ceteras/Cobra-XP/img/QR.png

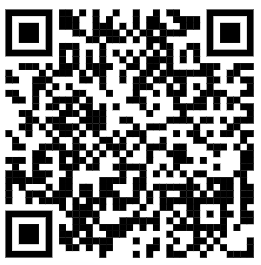
img/QR.png
