ceteras/Cobra-XP/extensions/template/img/template.pdf

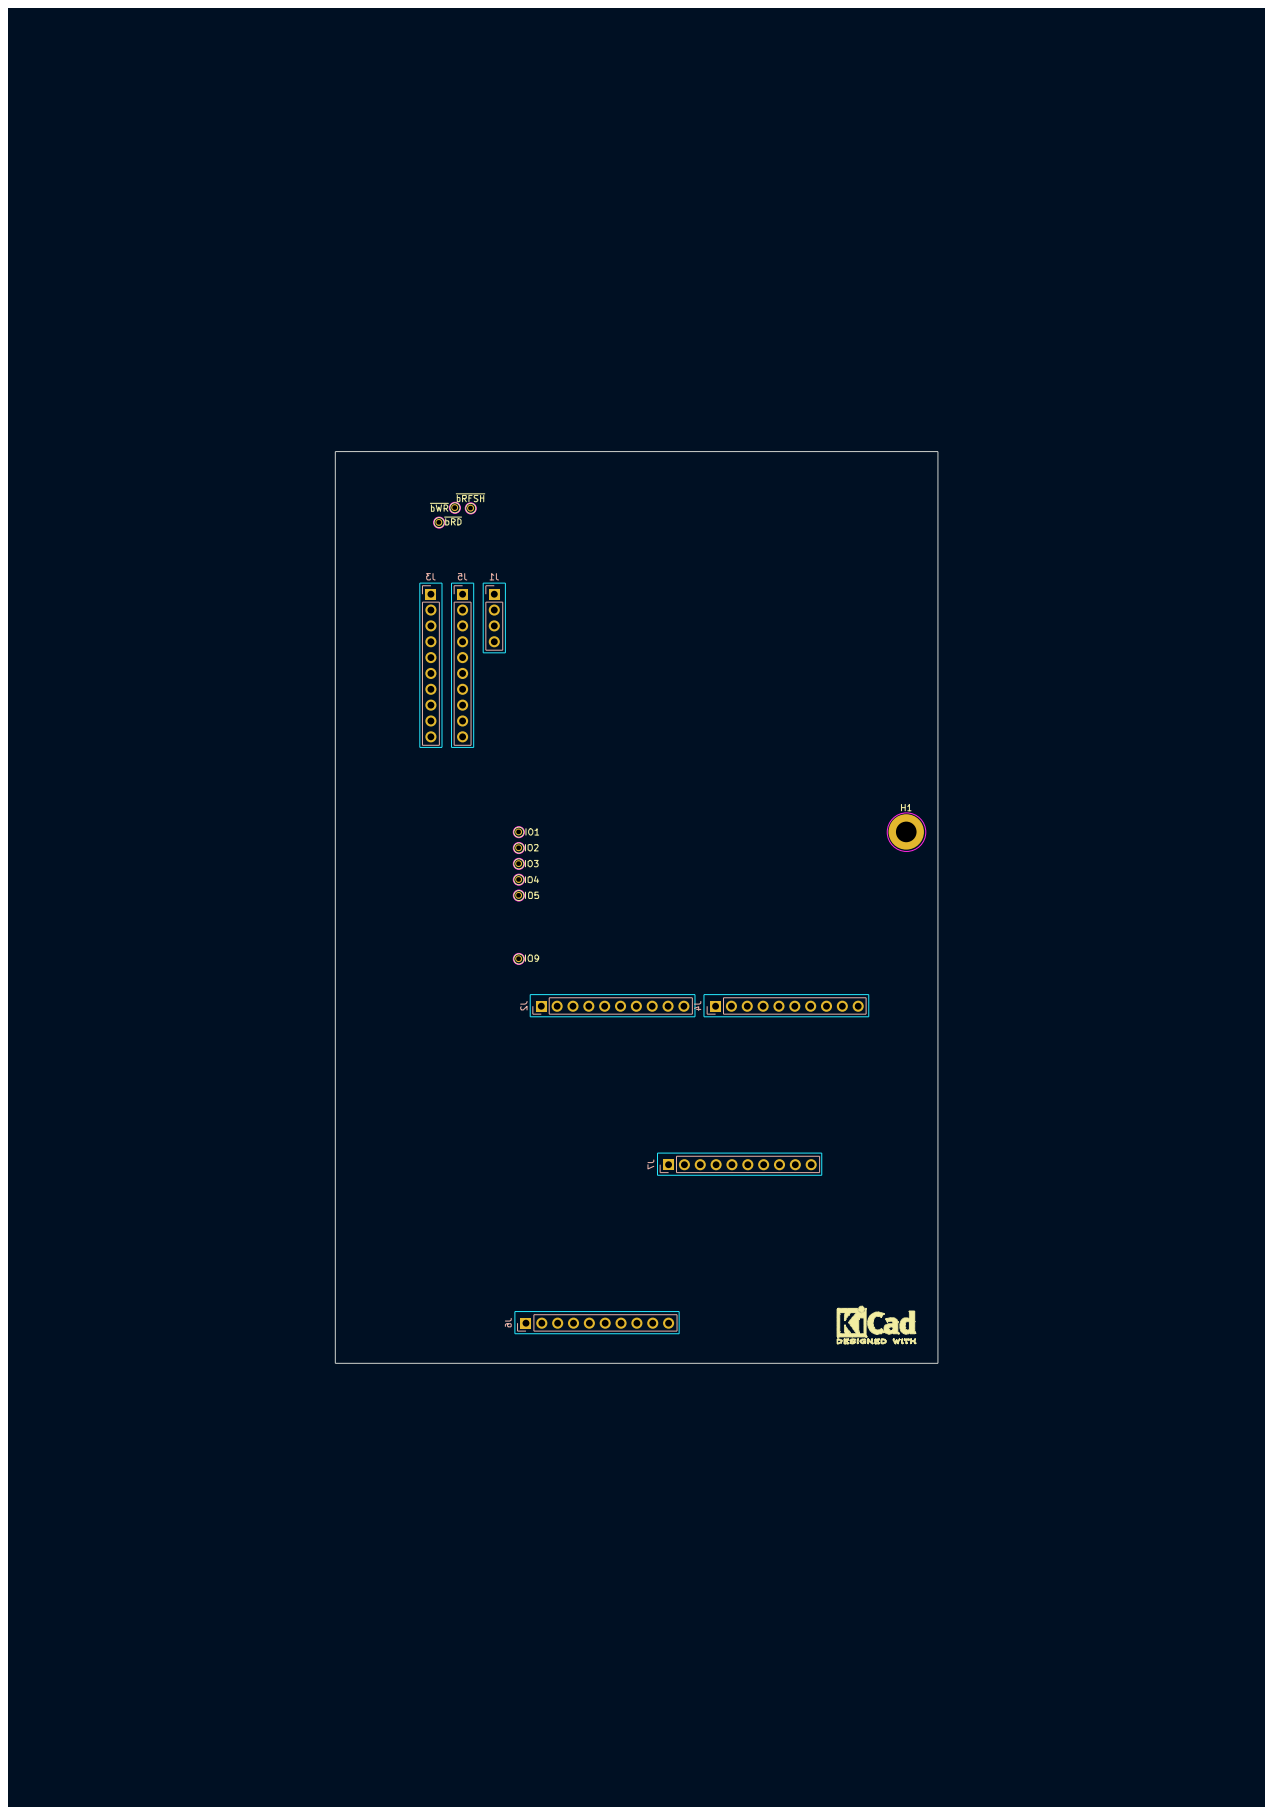
[picture p5: page 1]
