ceteras/Cobra-XP/kicad/Extras.kicad_sch

## KiCad design kicad/Extras.kicad_sch (2024-11-02)

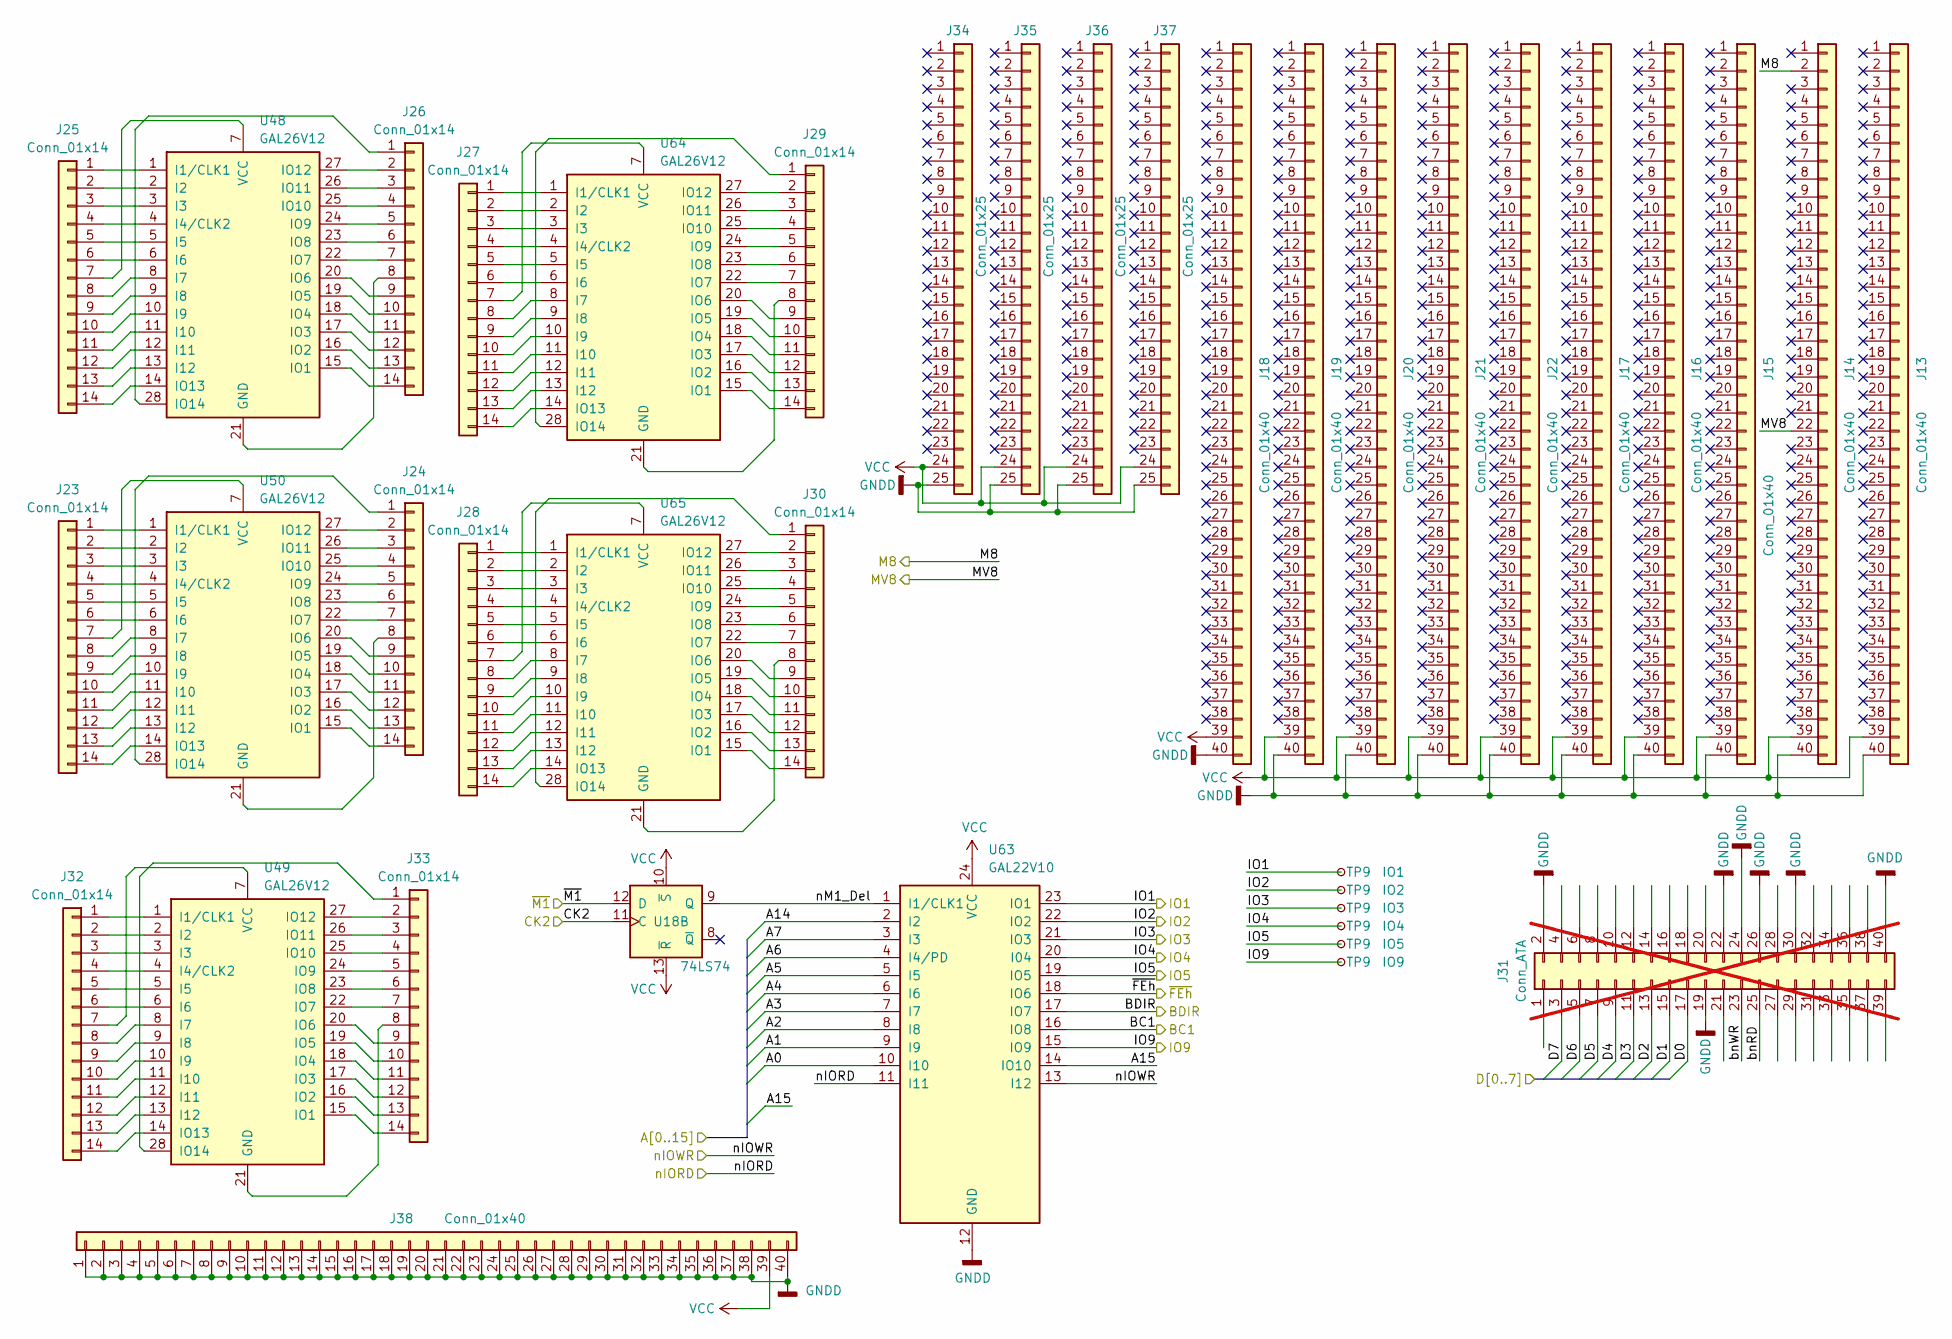
[picture p6: schematic Extras.kicad_sch]

Parts:
J13, J14, J15, J16, J17, J18, J19, J20, J21, J22, J38: Conn_01x40; PinHeader_1x40_P2.54mm_Vertical
J23, J24, J25, J26, J27, J28, J29, J30, J32, J33: Conn_01x14; PinHeader_1x14_P2.54mm_Vertical
J31: Conn_ATA; PinHeader_2x20_P2.54mm_Vertical; not fitted
J34, J35, J36, J37: Conn_01x25; PinHeader_1x25_P2.54mm_Vertical
TP9: IO2; TestPoint_Hole_D1mm_Drill0.6mm
U18: 74LS74; DIP-14_W7.62mm
U48, U49, U50, U64, U65: GAL26V12; DIP-28_W7.62mm
U63: GAL22V10; DIP-24_W7.62mm

Connections:
A0: U63.10 (I10)
A1: U63.9 (I9)
A2: U63.8 (I8)
A3: U63.7 (I7)
A4: U63.6 (I6)
A5: U63.5 (I5)
A6: U63.4 (I4/PD)
A7: U63.3 (I3)
A14: U63.2 (I2)
A15: U63.14 (IO10)
BC1: U63.16 (IO8)
BDIR: U63.17 (IO7)
CK2: U18.11 (C)
D0: J31.17
D1: J31.15
D2: J31.13
D3: J31.11
D4: J31.9
D5: J31.7
D6: J31.5
D7: J31.3
GNDD: J13.40, J14.40, J15.40, J16.40, J17.40, J18.40, J19.40, J20.40, J21.40, J22.40, J31.2, J31.19, J31.22, J31.24, J31.26, J31.30, J31.40, J34.25, J35.25, J36.25, J37.25, J38.1, J38.2, J38.3, J38.4, J38.5, J38.6, J38.7, J38.8, J38.9, J38.10, J38.11, J38.12, J38.13, J38.14, J38.15, J38.16, J38.17, J38.18, J38.19, J38.20, J38.21, J38.22, J38.23, J38.24, J38.25, J38.26, J38.27, J38.28, J38.29, J38.30, J38.31, J38.32, J38.33, J38.34, J38.35, J38.36, J38.37, J38.38, J38.40, U63.12 (GND)
IO1: TP9.1, U63.23 (IO1)
IO2: TP9.1, U63.22 (IO2)
IO3: TP9.1, U63.21 (IO3)
IO4: TP9.1, U63.20 (I04)
IO5: TP9.1, U63.19 (IO5)
IO9: TP9.1, U63.15 (IO9)
M8: J14.2
MV8: J14.22
unnamed: J23.1, U50.1 (I1/CLK1)
unnamed: J23.2, U50.2 (I2)
unnamed: J23.3, U50.3 (I3)
unnamed: J23.4, U50.4 (I4/CLK2)
unnamed: J23.5, U50.5 (I5)
unnamed: J23.6, U50.6 (I6)
unnamed: J23.7, U50.7 (VCC)
unnamed: J23.8, U50.8 (I7)
unnamed: J23.9, U50.9 (I8)
unnamed: J23.10, U50.10 (I9)
unnamed: J23.11, U50.11 (I10)
unnamed: J23.12, U50.12 (I11)
unnamed: J23.13, U50.13 (I12)
unnamed: J23.14, U50.14 (IO13)
unnamed: J24.1, U50.28 (IO14)
unnamed: J24.2, U50.27 (IO12)
unnamed: J24.3, U50.26 (IO11)
unnamed: J24.4, U50.25 (IO10)
unnamed: J24.5, U50.24 (IO9)
unnamed: J24.6, U50.23 (IO8)
unnamed: J24.7, U50.22 (IO7)
unnamed: J24.8, U50.21 (GND)
unnamed: J24.9, U50.20 (IO6)
unnamed: J24.10, U50.19 (IO5)
unnamed: J24.11, U50.18 (IO4)
unnamed: J24.12, U50.17 (IO3)
unnamed: J24.13, U50.16 (IO2)
unnamed: J24.14, U50.15 (IO1)
unnamed: J25.1, U48.1 (I1/CLK1)
unnamed: J25.2, U48.2 (I2)
unnamed: J25.3, U48.3 (I3)
unnamed: J25.4, U48.4 (I4/CLK2)
unnamed: J25.5, U48.5 (I5)
unnamed: J25.6, U48.6 (I6)
unnamed: J25.7, U48.7 (VCC)
unnamed: J25.8, U48.8 (I7)
unnamed: J25.9, U48.9 (I8)
unnamed: J25.10, U48.10 (I9)
unnamed: J25.11, U48.11 (I10)
unnamed: J25.12, U48.12 (I11)
unnamed: J25.13, U48.13 (I12)
unnamed: J25.14, U48.14 (IO13)
unnamed: J26.1, U48.28 (IO14)
unnamed: J26.2, U48.27 (IO12)
unnamed: J26.3, U48.26 (IO11)
unnamed: J26.4, U48.25 (IO10)
unnamed: J26.5, U48.24 (IO9)
unnamed: J26.6, U48.23 (IO8)
unnamed: J26.7, U48.22 (IO7)
unnamed: J26.8, U48.21 (GND)
unnamed: J26.9, U48.20 (IO6)
unnamed: J26.10, U48.19 (IO5)
unnamed: J26.11, U48.18 (IO4)
unnamed: J26.12, U48.17 (IO3)
unnamed: J26.13, U48.16 (IO2)
unnamed: J26.14, U48.15 (IO1)
unnamed: J27.1, U64.1 (I1/CLK1)
unnamed: J27.2, U64.2 (I2)
unnamed: J27.3, U64.3 (I3)
unnamed: J27.4, U64.4 (I4/CLK2)
unnamed: J27.5, U64.5 (I5)
unnamed: J27.6, U64.6 (I6)
unnamed: J27.7, U64.7 (VCC)
unnamed: J27.8, U64.8 (I7)
unnamed: J27.9, U64.9 (I8)
unnamed: J27.10, U64.10 (I9)
unnamed: J27.11, U64.11 (I10)
unnamed: J27.12, U64.12 (I11)
unnamed: J27.13, U64.13 (I12)
unnamed: J27.14, U64.14 (IO13)
unnamed: J28.1, U65.1 (I1/CLK1)
unnamed: J28.2, U65.2 (I2)
unnamed: J28.3, U65.3 (I3)
unnamed: J28.4, U65.4 (I4/CLK2)
unnamed: J28.5, U65.5 (I5)
unnamed: J28.6, U65.6 (I6)
unnamed: J28.7, U65.7 (VCC)
unnamed: J28.8, U65.8 (I7)
unnamed: J28.9, U65.9 (I8)
unnamed: J28.10, U65.10 (I9)
unnamed: J28.11, U65.11 (I10)
unnamed: J28.12, U65.12 (I11)
unnamed: J28.13, U65.13 (I12)
unnamed: J28.14, U65.14 (IO13)
unnamed: J29.1, U64.28 (IO14)
unnamed: J29.2, U64.27 (IO12)
unnamed: J29.3, U64.26 (IO11)
unnamed: J29.4, U64.25 (IO10)
unnamed: J29.5, U64.24 (IO9)
unnamed: J29.6, U64.23 (IO8)
unnamed: J29.7, U64.22 (IO7)
unnamed: J29.8, U64.21 (GND)
unnamed: J29.9, U64.20 (IO6)
unnamed: J29.10, U64.19 (IO5)
unnamed: J29.11, U64.18 (IO4)
unnamed: J29.12, U64.17 (IO3)
unnamed: J29.13, U64.16 (IO2)
unnamed: J29.14, U64.15 (IO1)
unnamed: J30.1, U65.28 (IO14)
unnamed: J30.2, U65.27 (IO12)
unnamed: J30.3, U65.26 (IO11)
unnamed: J30.4, U65.25 (IO10)
unnamed: J30.5, U65.24 (IO9)
unnamed: J30.6, U65.23 (IO8)
unnamed: J30.7, U65.22 (IO7)
unnamed: J30.8, U65.21 (GND)
unnamed: J30.9, U65.20 (IO6)
unnamed: J30.10, U65.19 (IO5)
unnamed: J30.11, U65.18 (IO4)
unnamed: J30.12, U65.17 (IO3)
unnamed: J30.13, U65.16 (IO2)
unnamed: J30.14, U65.15 (IO1)
unnamed: J32.1, U49.1 (I1/CLK1)
unnamed: J32.2, U49.2 (I2)
unnamed: J32.3, U49.3 (I3)
unnamed: J32.4, U49.4 (I4/CLK2)
unnamed: J32.5, U49.5 (I5)
unnamed: J32.6, U49.6 (I6)
unnamed: J32.7, U49.7 (VCC)
unnamed: J32.8, U49.8 (I7)
unnamed: J32.9, U49.9 (I8)
unnamed: J32.10, U49.10 (I9)
unnamed: J32.11, U49.11 (I10)
unnamed: J32.12, U49.12 (I11)
unnamed: J32.13, U49.13 (I12)
unnamed: J32.14, U49.14 (IO13)
unnamed: J33.1, U49.28 (IO14)
unnamed: J33.2, U49.27 (IO12)
unnamed: J33.3, U49.26 (IO11)
unnamed: J33.4, U49.25 (IO10)
unnamed: J33.5, U49.24 (IO9)
unnamed: J33.6, U49.23 (IO8)
unnamed: J33.7, U49.22 (IO7)
unnamed: J33.8, U49.21 (GND)
unnamed: J33.9, U49.20 (IO6)
unnamed: J33.10, U49.19 (IO5)
unnamed: J33.11, U49.18 (IO4)
unnamed: J33.12, U49.17 (IO3)
unnamed: J33.13, U49.16 (IO2)
unnamed: J33.14, U49.15 (IO1)
VCC: J13.39, J14.39, J15.39, J16.39, J17.39, J18.39, J19.39, J20.39, J21.39, J22.39, J34.24, J35.24, J36.24, J37.24, J38.39, U18.10 (~S), U18.13 (~R), U63.24 (VCC)
bnRD: J31.25
bnWR: J31.23
nIORD: U63.11 (I11)
nIOWR: U63.13 (I12)
nM1_Del: U18.9 (Q), U63.1 (I1/CLK1)
~FEh: U63.18 (IO6)
~M1: U18.12 (D)
