ceteras/Cobra-XP/kicad/RAM_48.kicad_sch

## KiCad design kicad/RAM_48.kicad_sch (2024-11-02)

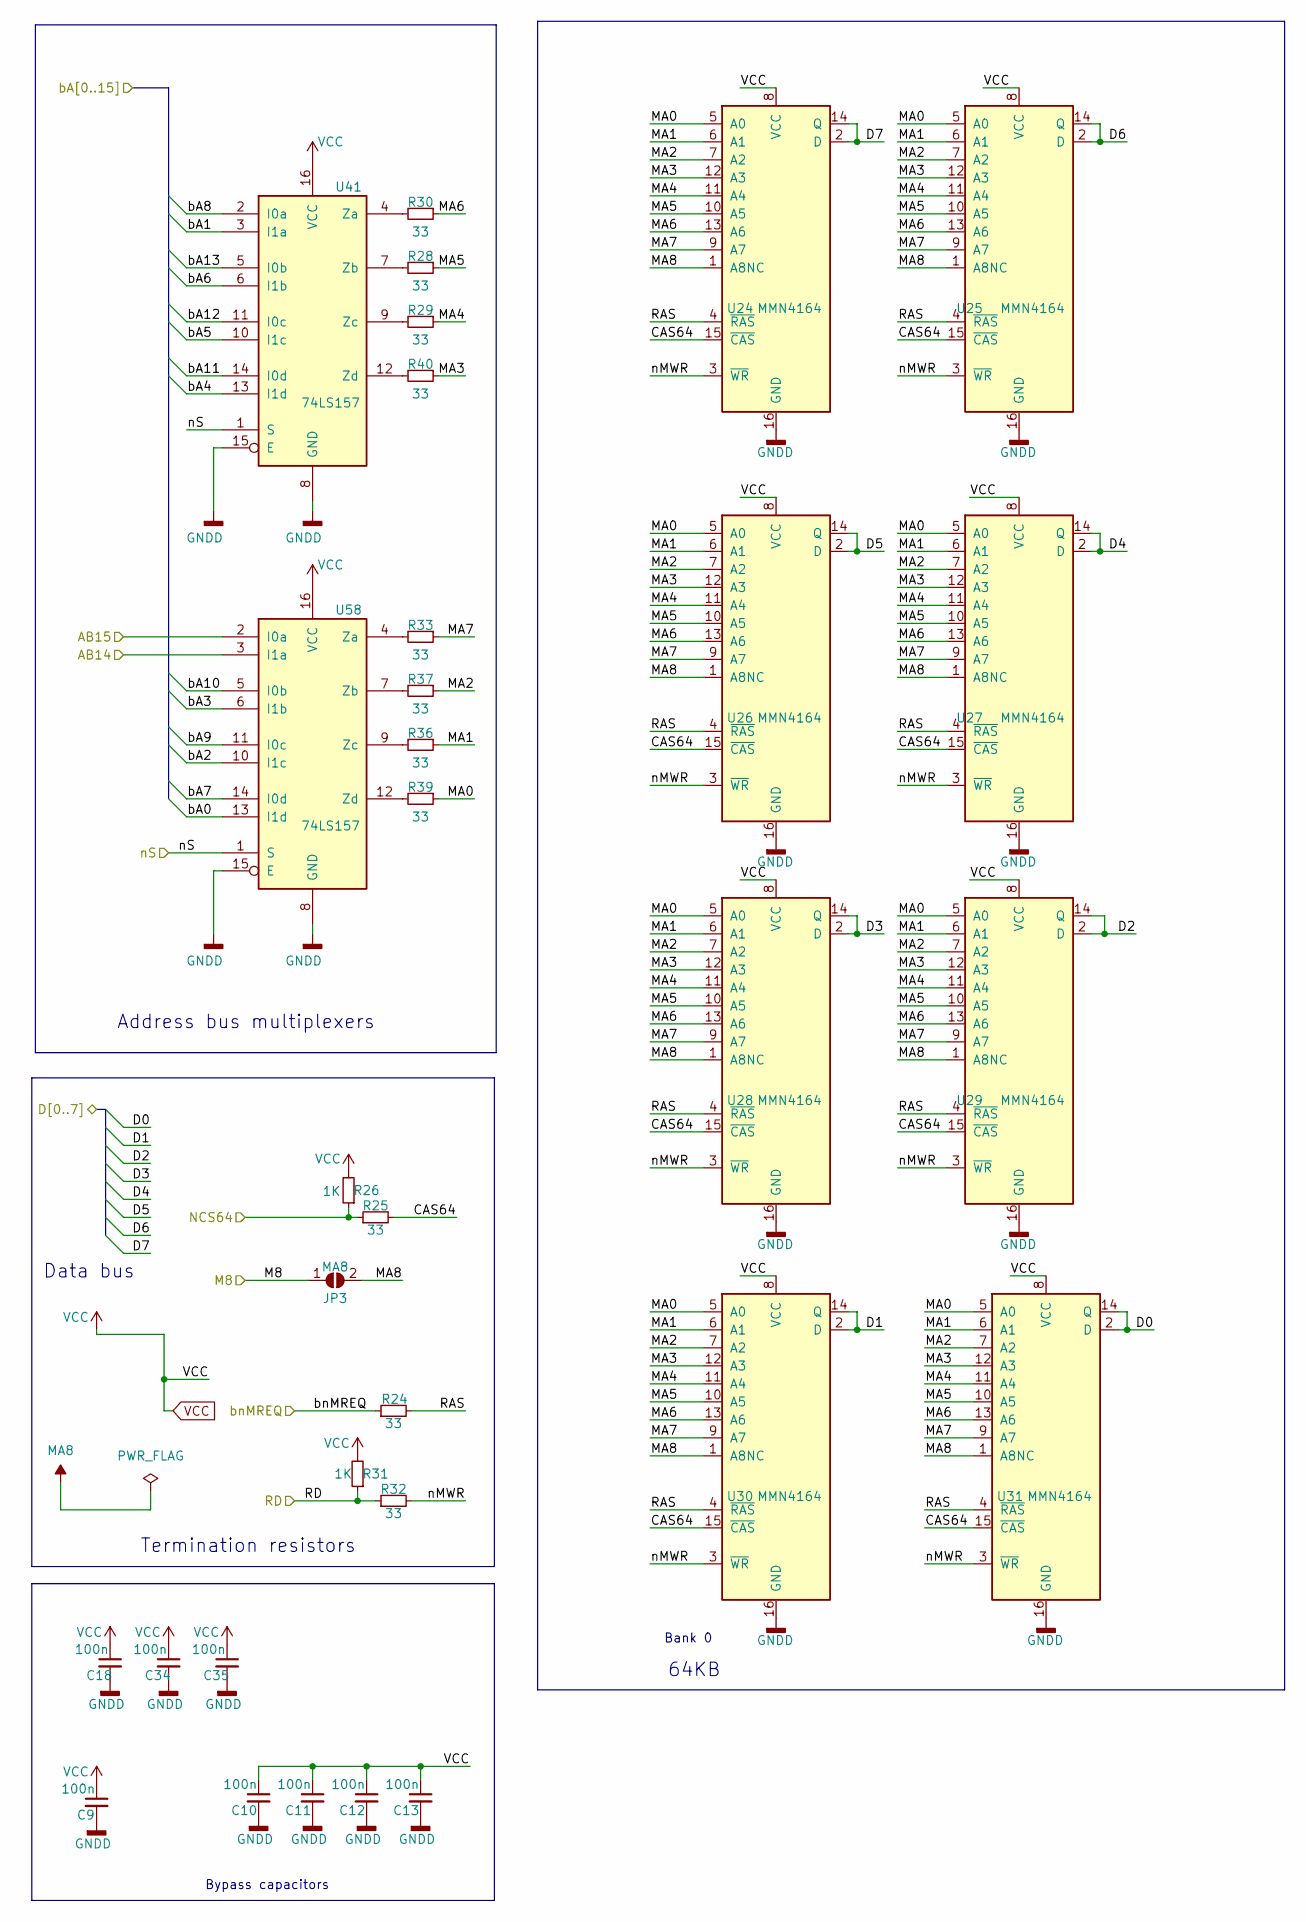
[picture p10: schematic RAM_48.kicad_sch]

Parts:
C9, C10, C11, C12, C13, C18, C34, C35: 100n; C_THT_762_254
JP3: MA8; SolderJumper-2_P1.3mm_Open_TrianglePad1.0x1.5mm
R24, R25, R28, R29, R30, R32, R33, R36, R37, R39, R40: 33; R_Axial_DIN0204_L3.6mm_D1.6mm_P5.08mm_Horizontal
R26, R31: 1K; R_Axial_DIN0204_L3.6mm_D1.6mm_P5.08mm_Horizontal
U24, U25, U26, U27, U28, U29, U30, U31: MMN4164; DIP-16_W7.62mm
U41, U58: 74LS157; DIP-16_W7.62mm

Connections:
AB14: U58.3 (I1a)
AB15: U58.2 (I0a)
CAS64: R25.2, U24.15 (~CAS), U25.15 (~CAS), U26.15 (~CAS), U27.15 (~CAS), U28.15 (~CAS), U29.15 (~CAS), U30.15 (~CAS), U31.15 (~CAS)
D0: U31.2 (D), U31.14 (Q)
D1: U30.2 (D), U30.14 (Q)
D2: U29.2 (D), U29.14 (Q)
D3: U28.2 (D), U28.14 (Q)
D4: U27.2 (D), U27.14 (Q)
D5: U26.2 (D), U26.14 (Q)
D6: U25.2 (D), U25.14 (Q)
D7: U24.2 (D), U24.14 (Q)
GNDD: C9.2, C10.2, C11.2, C12.2, C13.2, C18.2, C34.2, C35.2, U24.16 (GND), U25.16 (GND), U26.16 (GND), U27.16 (GND), U28.16 (GND), U29.16 (GND), U30.16 (GND), U31.16 (GND), U41.8 (GND), U41.15 (E), U58.8 (GND), U58.15 (E)
M8: JP3.1 (A)
MA0: R39.1, U24.5 (A0), U25.5 (A0), U26.5 (A0), U27.5 (A0), U28.5 (A0), U29.5 (A0), U30.5 (A0), U31.5 (A0)
MA1: R36.1, U24.6 (A1), U25.6 (A1), U26.6 (A1), U27.6 (A1), U28.6 (A1), U29.6 (A1), U30.6 (A1), U31.6 (A1)
MA2: R37.1, U24.7 (A2), U25.7 (A2), U26.7 (A2), U27.7 (A2), U28.7 (A2), U29.7 (A2), U30.7 (A2), U31.7 (A2)
MA3: R40.1, U24.12 (A3), U25.12 (A3), U26.12 (A3), U27.12 (A3), U28.12 (A3), U29.12 (A3), U30.12 (A3), U31.12 (A3)
MA4: R29.1, U24.11 (A4), U25.11 (A4), U26.11 (A4), U27.11 (A4), U28.11 (A4), U29.11 (A4), U30.11 (A4), U31.11 (A4)
MA5: R28.1, U24.10 (A5), U25.10 (A5), U26.10 (A5), U27.10 (A5), U28.10 (A5), U29.10 (A5), U30.10 (A5), U31.10 (A5)
MA6: R30.1, U24.13 (A6), U25.13 (A6), U26.13 (A6), U27.13 (A6), U28.13 (A6), U29.13 (A6), U30.13 (A6), U31.13 (A6)
MA7: R33.1, U24.9 (A7), U25.9 (A7), U26.9 (A7), U27.9 (A7), U28.9 (A7), U29.9 (A7), U30.9 (A7), U31.9 (A7)
MA8: JP3.2 (B), U24.1 (A8NC), U25.1 (A8NC), U26.1 (A8NC), U27.1 (A8NC), U28.1 (A8NC), U29.1 (A8NC), U30.1 (A8NC), U31.1 (A8NC)
NCS64: R25.1, R26.1
unnamed: R28.2, U41.7 (Zb)
unnamed: R29.2, U41.9 (Zc)
unnamed: R30.2, U41.4 (Za)
unnamed: R33.2, U58.4 (Za)
unnamed: R36.2, U58.9 (Zc)
unnamed: R37.2, U58.7 (Zb)
unnamed: R39.2, U58.12 (Zd)
unnamed: R40.2, U41.12 (Zd)
RAS: R24.2, U24.4 (~RAS), U25.4 (~RAS), U26.4 (~RAS), U27.4 (~RAS), U28.4 (~RAS), U29.4 (~RAS), U30.4 (~RAS), U31.4 (~RAS)
RD: R31.1, R32.1
VCC: C9.1, C10.1, C11.1, C12.1, C13.1, C18.1, C34.1, C35.1, R26.2, R31.2, U24.8 (VCC), U25.8 (VCC), U26.8 (VCC), U27.8 (VCC), U28.8 (VCC), U29.8 (VCC), U30.8 (VCC), U31.8 (VCC), U41.16 (VCC), U58.16 (VCC)
bA0: U58.13 (I1d)
bA1: U41.3 (I1a)
bA2: U58.10 (I1c)
bA3: U58.6 (I1b)
bA4: U41.13 (I1d)
bA5: U41.10 (I1c)
bA6: U41.6 (I1b)
bA7: U58.14 (I0d)
bA8: U41.2 (I0a)
bA9: U58.11 (I0c)
bA10: U58.5 (I0b)
bA11: U41.14 (I0d)
bA12: U41.11 (I0c)
bA13: U41.5 (I0b)
bnMREQ: R24.1
nMWR: R32.2, U24.3 (~WR), U25.3 (~WR), U26.3 (~WR), U27.3 (~WR), U28.3 (~WR), U29.3 (~WR), U30.3 (~WR), U31.3 (~WR)
nS: U41.1 (S), U58.1 (S)

Notes on the sheet:
Bypass capacitors
Data bus
Address bus multiplexers
64KB
Bank 0
Termination resistors
