ceteras/Cobra-XP/kicad/ROM.kicad_sch

## KiCad design kicad/ROM.kicad_sch (2024-11-02)

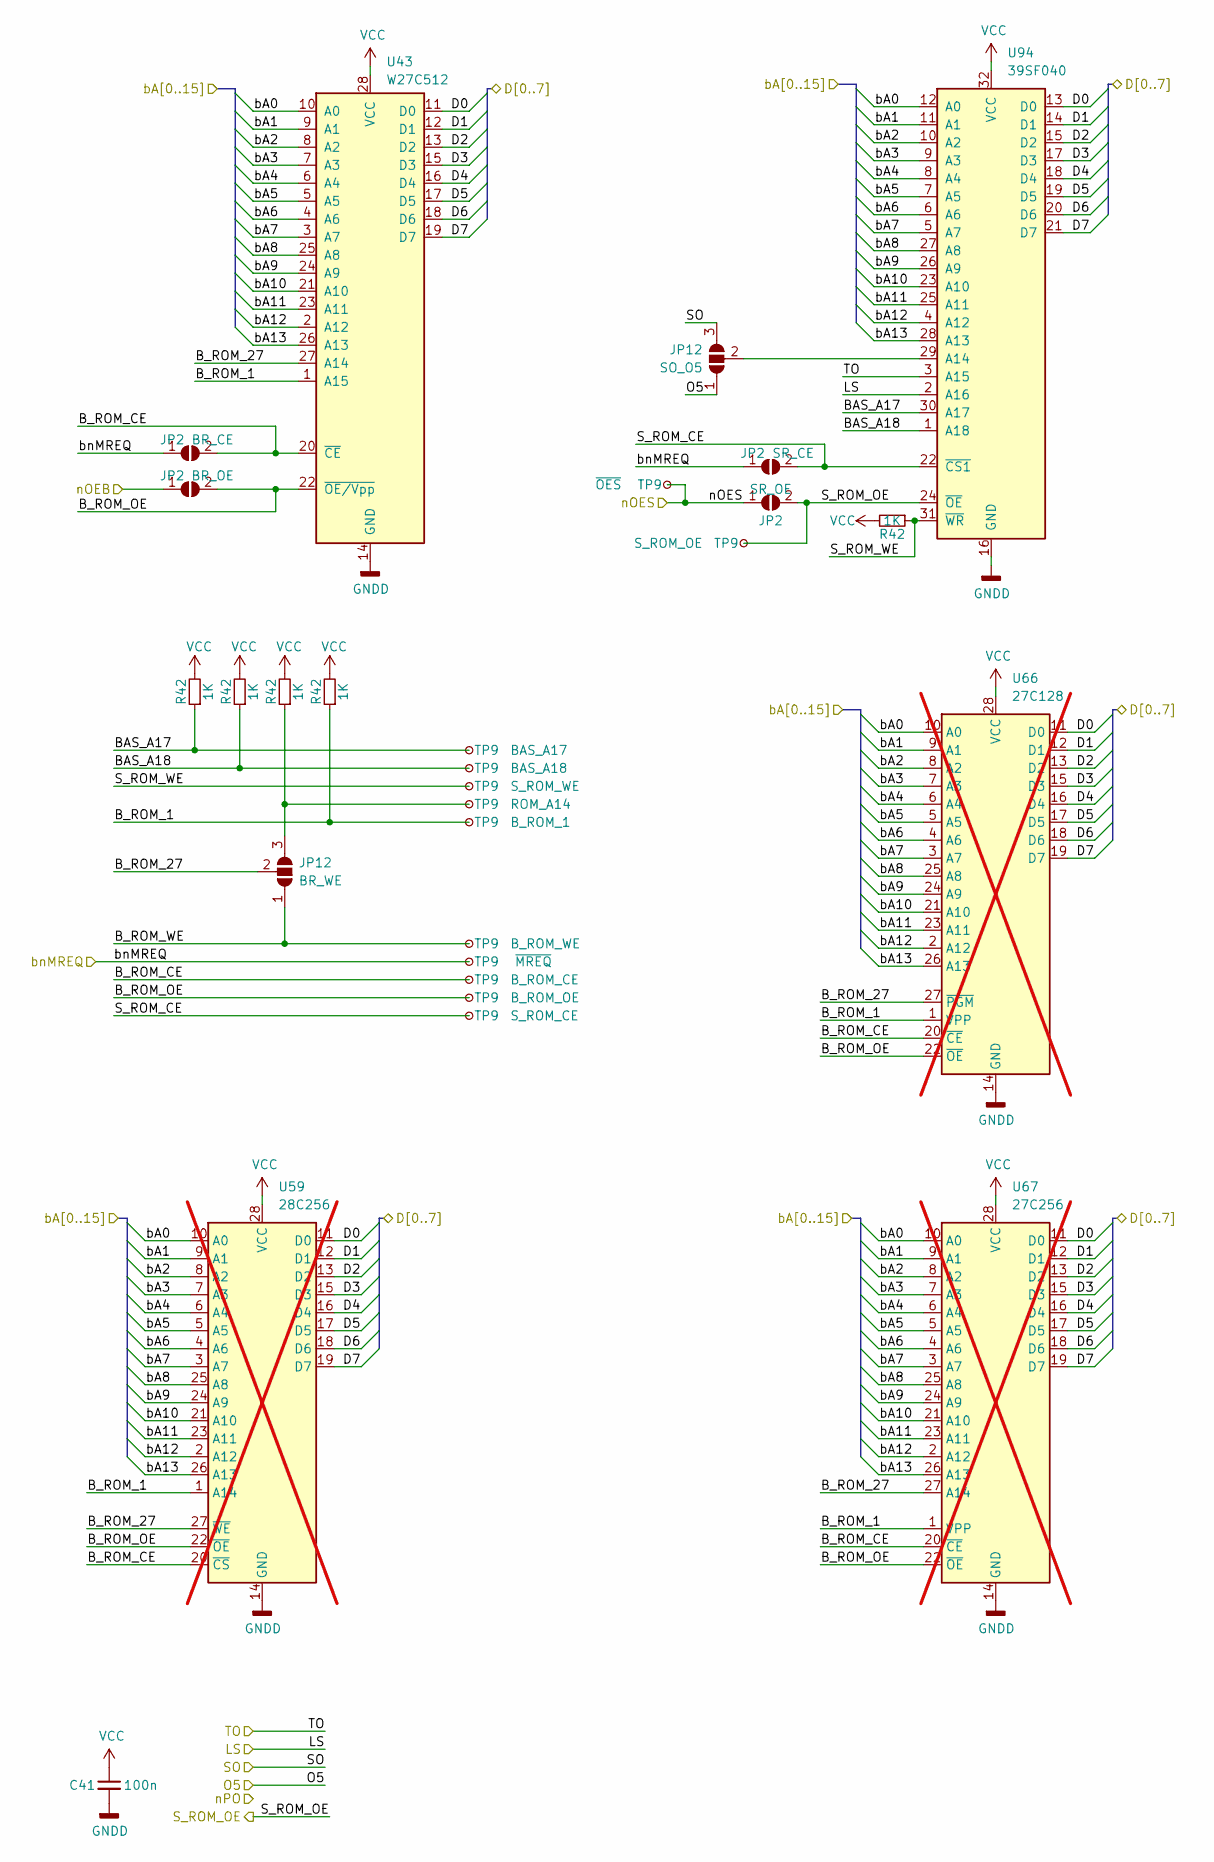
[picture p11: schematic ROM.kicad_sch]

Parts:
C41: 100n; C_THT_508_254
JP2: BR_CE; SolderJumper-2_P1.3mm_Open_TrianglePad1.0x1.5mm
JP12: SO_O5; SolderJumper-3_P2.0mm_Open_TrianglePad1.0x1.5mm
R42: 1K; R_Axial_DIN0204_L3.6mm_D1.6mm_P5.08mm_Horizontal
TP9: B_ROM_1; TestPoint_Hole_D1mm_Drill0.6mm
U43: W27C512; DIP-28_W15.24mm
U59: 28C256; not fitted
U66: 27C128; DIP-28_W15.24mm; not fitted
U67: 27C256; DIP-28_W15.24mm; not fitted
U94: 39SF040; DIP-32_W15.24mm

Connections:
BAS_A17: R42.1, TP9.1, U94.30 (A17)
BAS_A18: R42.1, TP9.1, U94.1 (A18)
B_ROM_1: R42.1, TP9.1, U43.1 (A15), U59.1 (A14), U66.1 (VPP), U67.1 (VPP)
B_ROM_27: JP12.2 (C), U43.27 (A14), U59.27 (~WE), U66.27 (~PGM), U67.27 (A14)
B_ROM_CE: JP2.2 (B), TP9.1, U43.20 (~CE), U59.20 (~CS), U66.20 (~CE), U67.20 (~CE)
B_ROM_OE: JP2.2 (B), TP9.1, U43.22 (~OE/Vpp), U59.22 (~OE), U66.22 (~OE), U67.22 (~OE)
B_ROM_WE: JP12.1 (A), TP9.1
D0: U43.11 (D0), U59.11 (D0), U66.11 (D0), U67.11 (D0), U94.13 (D0)
D1: U43.12 (D1), U59.12 (D1), U66.12 (D1), U67.12 (D1), U94.14 (D1)
D2: U43.13 (D2), U59.13 (D2), U66.13 (D2), U67.13 (D2), U94.15 (D2)
D3: U43.15 (D3), U59.15 (D3), U66.15 (D3), U67.15 (D3), U94.17 (D3)
D4: U43.16 (D4), U59.16 (D4), U66.16 (D4), U67.16 (D4), U94.18 (D4)
D5: U43.17 (D5), U59.17 (D5), U66.17 (D5), U67.17 (D5), U94.19 (D5)
D6: U43.18 (D6), U59.18 (D6), U66.18 (D6), U67.18 (D6), U94.20 (D6)
D7: U43.19 (D7), U59.19 (D7), U66.19 (D7), U67.19 (D7), U94.21 (D7)
GNDD: C41.2, U43.14 (GND), U59.14 (GND), U66.14 (GND), U67.14 (GND), U94.16 (GND)
LS: U94.2 (A16)
unnamed: JP12.2 (C), U94.29 (A14)
unnamed: JP12.3 (B), R42.1, TP9.1
O5: JP12.1 (A)
SO: JP12.3 (B)
S_ROM_CE: JP2.2 (B), TP9.1, U94.22 (~CS1)
S_ROM_OE: JP2.2 (B), TP9.1, U94.24 (~OE)
S_ROM_WE: R42.1, TP9.1, U94.31 (~WR)
TO: U94.3 (A15)
VCC: C41.1, R42.2, U43.28 (VCC), U59.28 (VCC), U66.28 (VCC), U67.28 (VCC), U94.32 (VCC)
bA0: U43.10 (A0), U59.10 (A0), U66.10 (A0), U67.10 (A0), U94.12 (A0)
bA1: U43.9 (A1), U59.9 (A1), U66.9 (A1), U67.9 (A1), U94.11 (A1)
bA2: U43.8 (A2), U59.8 (A2), U66.8 (A2), U67.8 (A2), U94.10 (A2)
bA3: U43.7 (A3), U59.7 (A3), U66.7 (A3), U67.7 (A3), U94.9 (A3)
bA4: U43.6 (A4), U59.6 (A4), U66.6 (A4), U67.6 (A4), U94.8 (A4)
bA5: U43.5 (A5), U59.5 (A5), U66.5 (A5), U67.5 (A5), U94.7 (A5)
bA6: U43.4 (A6), U59.4 (A6), U66.4 (A6), U67.4 (A6), U94.6 (A6)
bA7: U43.3 (A7), U59.3 (A7), U66.3 (A7), U67.3 (A7), U94.5 (A7)
bA8: U43.25 (A8), U59.25 (A8), U66.25 (A8), U67.25 (A8), U94.27 (A8)
bA9: U43.24 (A9), U59.24 (A9), U66.24 (A9), U67.24 (A9), U94.26 (A9)
bA10: U43.21 (A10), U59.21 (A10), U66.21 (A10), U67.21 (A10), U94.23 (A10)
bA11: U43.23 (A11), U59.23 (A11), U66.23 (A11), U67.23 (A11), U94.25 (A11)
bA12: U43.2 (A12), U59.2 (A12), U66.2 (A12), U67.2 (A12), U94.4 (A12)
bA13: U43.26 (A13), U59.26 (A13), U66.26 (A13), U67.26 (A13), U94.28 (A13)
bnMREQ: JP2.1 (A), TP9.1
nOEB: JP2.1 (A)
nOES: JP2.1 (A), TP9.1
