ceteras/Cobra-XP/kicad/Video_memory.kicad_sch

## KiCad design kicad/Video_memory.kicad_sch (2024-11-02)

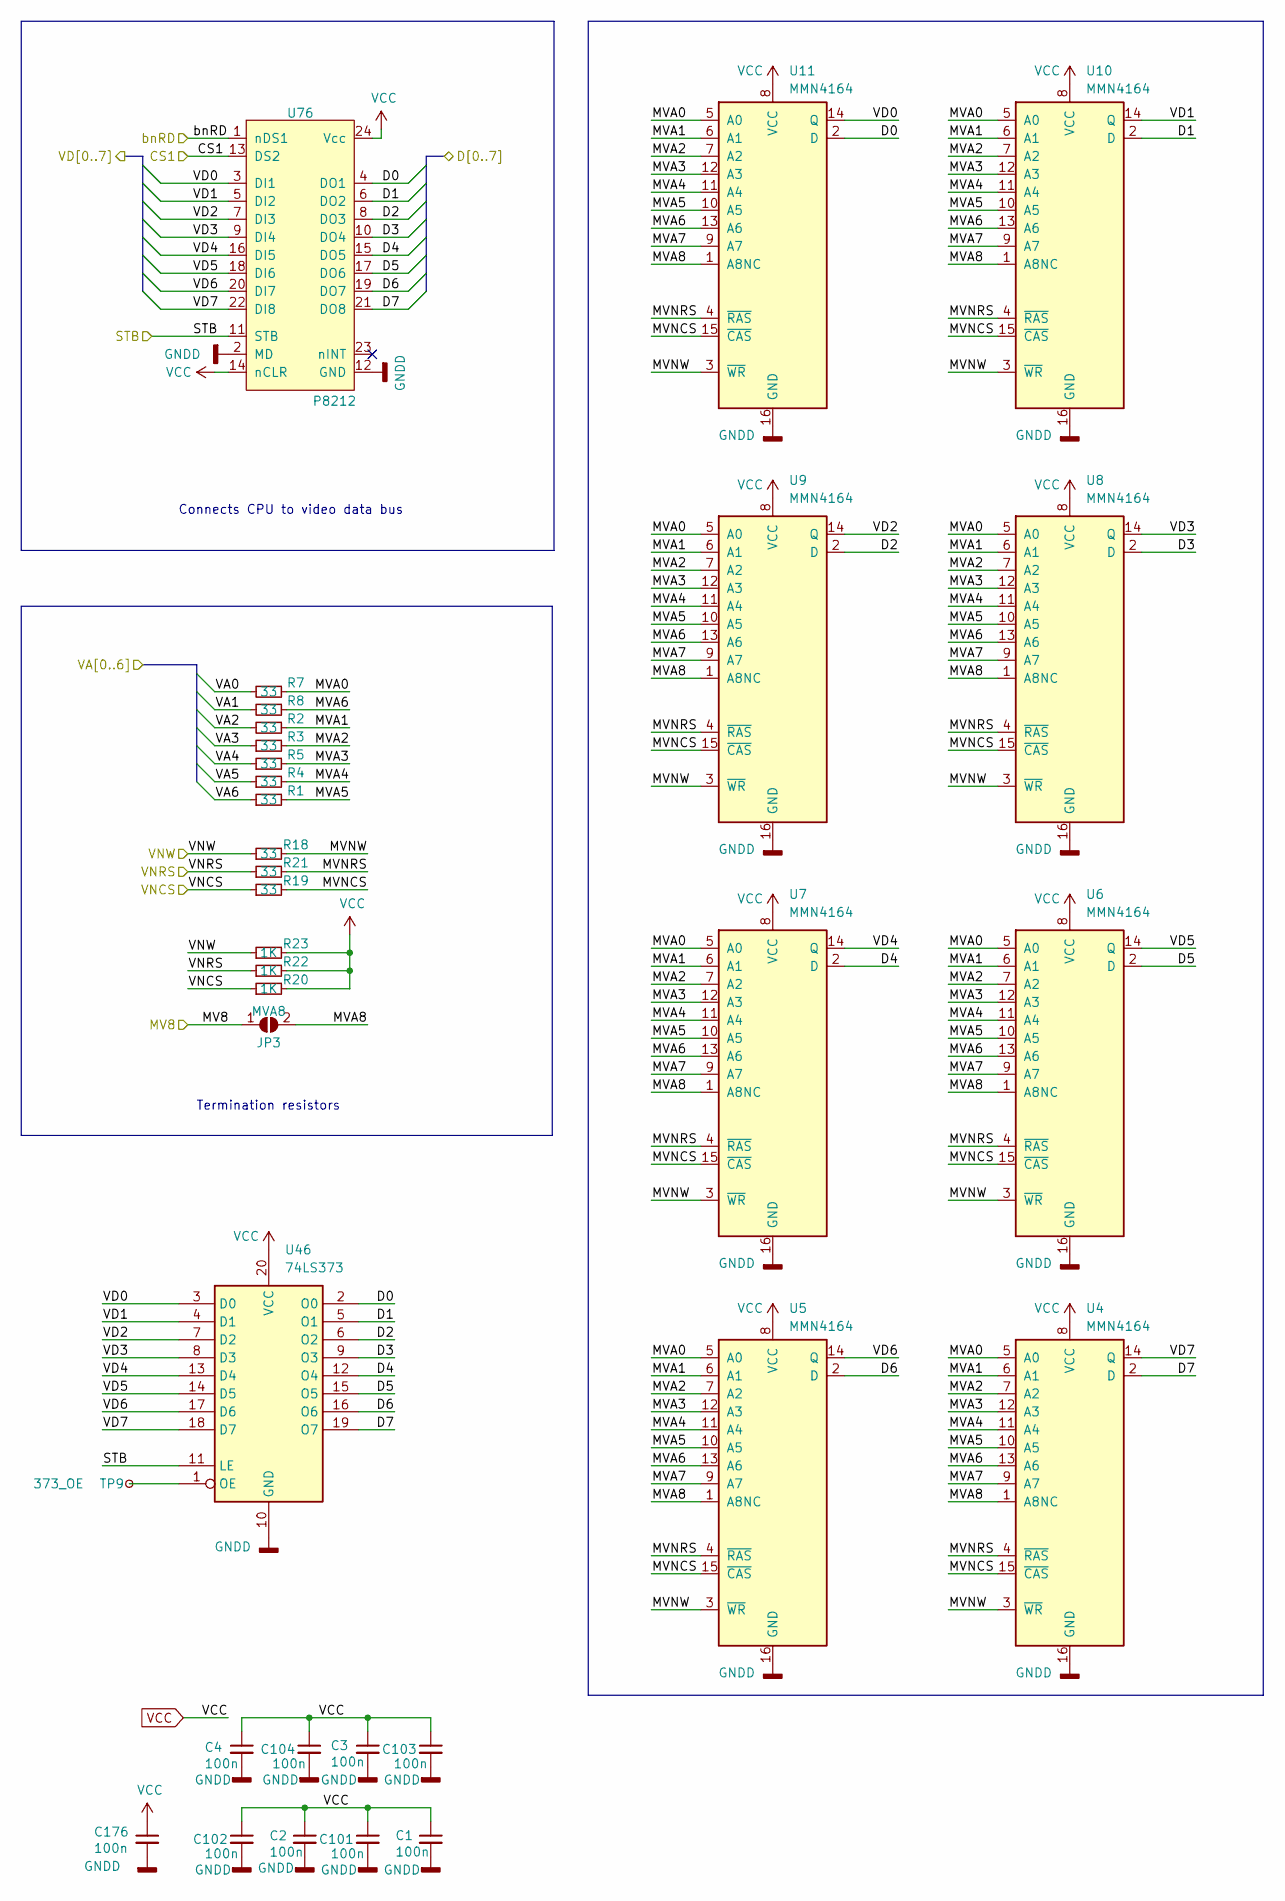
[picture p13: schematic Video_memory.kicad_sch]

Parts:
C1, C2, C3, C4, C101, C102, C103, C104: 100n; C_THT_762_254
C176: 100n; C_THT_508_254
JP3: MVA8; SolderJumper-2_P1.3mm_Open_TrianglePad1.0x1.5mm
R1, R2, R3, R4, R5, R7, R8, R18, R19, R21: 33; R_Axial_DIN0204_L3.6mm_D1.6mm_P5.08mm_Horizontal
R20, R22, R23: 1K; R_Axial_DIN0204_L3.6mm_D1.6mm_P5.08mm_Horizontal
TP9: 373_OE; TestPoint_Hole_D1mm_Drill0.6mm
U4, U5, U6, U7, U8, U9, U10, U11: MMN4164; DIP-16_W7.62mm
U46: 74LS373; DIP-20_W7.62mm
U76: P8212; DIP-24_W15.24mm_0.9DI

Connections:
CS1: U76.13 (DS2)
D0: U11.2 (D), U46.2 (O0), U76.4 (DO1)
D1: U10.2 (D), U46.5 (O1), U76.6 (DO2)
D2: U9.2 (D), U46.6 (O2), U76.8 (DO3)
D3: U8.2 (D), U46.9 (O3), U76.10 (DO4)
D4: U7.2 (D), U46.12 (O4), U76.15 (DO5)
D5: U6.2 (D), U46.15 (O5), U76.17 (DO6)
D6: U5.2 (D), U46.16 (O6), U76.19 (DO7)
D7: U4.2 (D), U46.19 (O7), U76.21 (DO8)
GNDD: C1.2, C2.2, C3.2, C4.2, C101.2, C102.2, C103.2, C104.2, C176.2, U4.16 (GND), U5.16 (GND), U6.16 (GND), U7.16 (GND), U8.16 (GND), U9.16 (GND), U10.16 (GND), U11.16 (GND), U46.10 (GND), U76.2 (MD), U76.12 (GND)
MV8: JP3.1 (A)
MVA0: R7.1, U4.5 (A0), U5.5 (A0), U6.5 (A0), U7.5 (A0), U8.5 (A0), U9.5 (A0), U10.5 (A0), U11.5 (A0)
MVA1: R2.1, U4.6 (A1), U5.6 (A1), U6.6 (A1), U7.6 (A1), U8.6 (A1), U9.6 (A1), U10.6 (A1), U11.6 (A1)
MVA2: R3.2, U4.7 (A2), U5.7 (A2), U6.7 (A2), U7.7 (A2), U8.7 (A2), U9.7 (A2), U10.7 (A2), U11.7 (A2)
MVA3: R5.2, U4.12 (A3), U5.12 (A3), U6.12 (A3), U7.12 (A3), U8.12 (A3), U9.12 (A3), U10.12 (A3), U11.12 (A3)
MVA4: R4.2, U4.11 (A4), U5.11 (A4), U6.11 (A4), U7.11 (A4), U8.11 (A4), U9.11 (A4), U10.11 (A4), U11.11 (A4)
MVA5: R1.2, U4.10 (A5), U5.10 (A5), U6.10 (A5), U7.10 (A5), U8.10 (A5), U9.10 (A5), U10.10 (A5), U11.10 (A5)
MVA6: R8.1, U4.13 (A6), U5.13 (A6), U6.13 (A6), U7.13 (A6), U8.13 (A6), U9.13 (A6), U10.13 (A6), U11.13 (A6)
MVA7: U4.9 (A7), U5.9 (A7), U6.9 (A7), U7.9 (A7), U8.9 (A7), U9.9 (A7), U10.9 (A7), U11.9 (A7)
MVA8: JP3.2 (B), U4.1 (A8NC), U5.1 (A8NC), U6.1 (A8NC), U7.1 (A8NC), U8.1 (A8NC), U9.1 (A8NC), U10.1 (A8NC), U11.1 (A8NC)
MVNCS: R19.2, U4.15 (~CAS), U5.15 (~CAS), U6.15 (~CAS), U7.15 (~CAS), U8.15 (~CAS), U9.15 (~CAS), U10.15 (~CAS), U11.15 (~CAS)
MVNRS: R21.2, U4.4 (~RAS), U5.4 (~RAS), U6.4 (~RAS), U7.4 (~RAS), U8.4 (~RAS), U9.4 (~RAS), U10.4 (~RAS), U11.4 (~RAS)
MVNW: R18.2, U4.3 (~WR), U5.3 (~WR), U6.3 (~WR), U7.3 (~WR), U8.3 (~WR), U9.3 (~WR), U10.3 (~WR), U11.3 (~WR)
unnamed: TP9.1, U46.1 (OE)
STB: U46.11 (LE), U76.11 (STB)
VA0: R7.2
VA1: R8.2
VA2: R2.2
VA3: R3.1
VA4: R5.1
VA5: R4.1
VA6: R1.1
VCC: C1.1, C2.1, C3.1, C4.1, C101.1, C102.1, C103.1, C104.1, C176.1, R20.2, R22.2, R23.2, U4.8 (VCC), U5.8 (VCC), U6.8 (VCC), U7.8 (VCC), U8.8 (VCC), U9.8 (VCC), U10.8 (VCC), U11.8 (VCC), U46.20 (VCC), U76.14 (nCLR), U76.24 (Vcc)
VD0: U11.14 (Q), U46.3 (D0), U76.3 (DI1)
VD1: U10.14 (Q), U46.4 (D1), U76.5 (DI2)
VD2: U9.14 (Q), U46.7 (D2), U76.7 (DI3)
VD3: U8.14 (Q), U46.8 (D3), U76.9 (DI4)
VD4: U7.14 (Q), U46.13 (D4), U76.16 (DI5)
VD5: U6.14 (Q), U46.14 (D5), U76.18 (DI6)
VD6: U5.14 (Q), U46.17 (D6), U76.20 (DI7)
VD7: U4.14 (Q), U46.18 (D7), U76.22 (DI8)
VNCS: R19.1, R20.1
VNRS: R21.1, R22.1
VNW: R18.1, R23.1
bnRD: U76.1 (nDS1)

Notes on the sheet:
Connects CPU to video data bus
Termination resistors
