ceteras/Cobra-XP/kicad/audio.kicad_sch

## KiCad design kicad/audio.kicad_sch (2024-11-02)

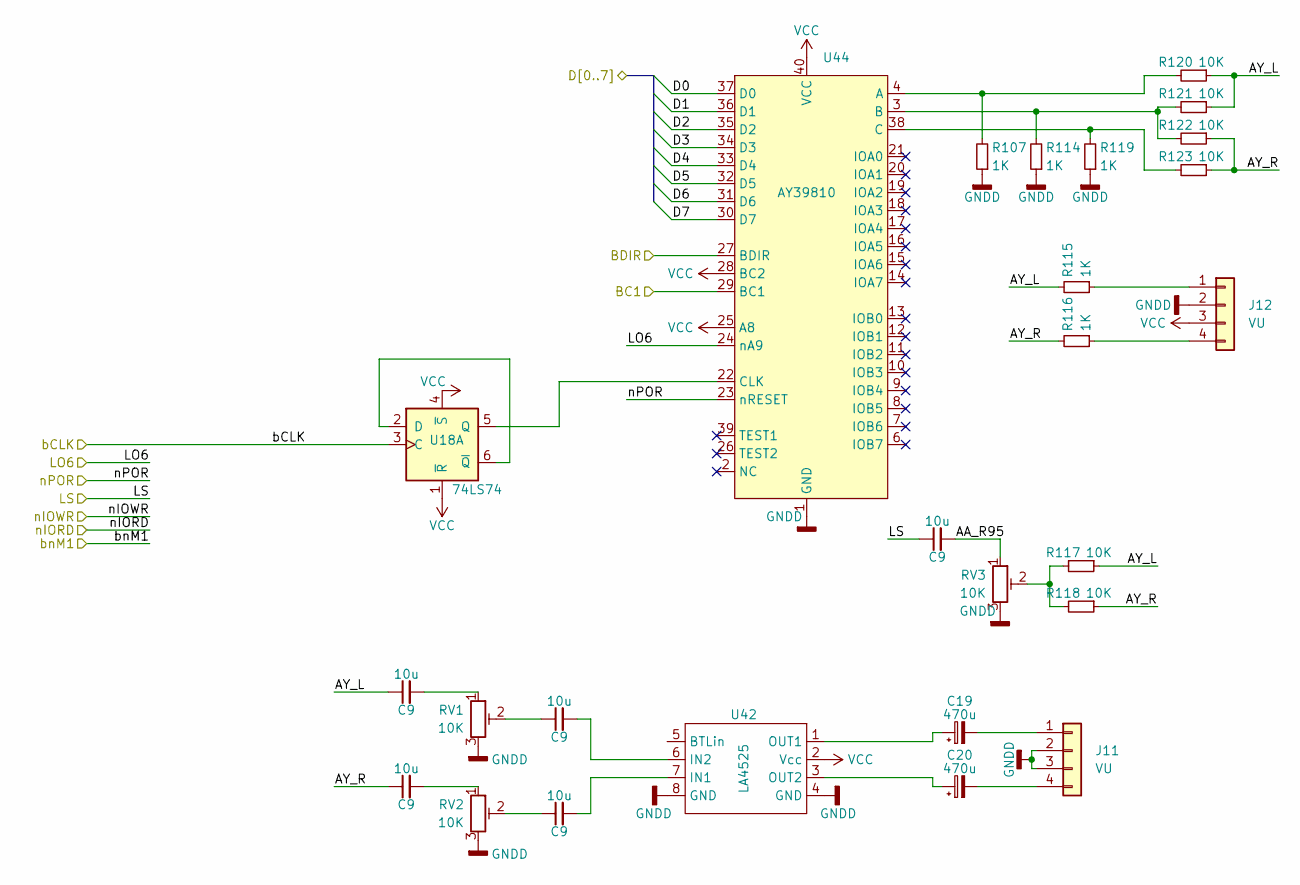
[picture p15: schematic audio.kicad_sch]

Parts:
C9: 10u; C_THT_508_254
C19, C20: 470u; CP_Radial_D6.3mm_P2.50mm
J11, J12: VU; JST_EH_B4B-EH-A_1x04_P2.50mm_Vertical
R107, R114, R115, R116, R119: 1K; R_Axial_DIN0204_L3.6mm_D1.6mm_P5.08mm_Horizontal
R117, R118, R120, R121, R122, R123: 10K; R_Axial_DIN0204_L3.6mm_D1.6mm_P5.08mm_Horizontal
RV1, RV2, RV3: 10K; TRIM_3296W-1-250
U18: 74LS74; DIP-14_W7.62mm
U42: LA4525; DIP-8_W7.62mm
U44: AY39810; DIP-40_W15.24mm

Connections:
AA_R95: C9.2, RV3.1
AY_L: C9.1, R115.2, R117.1, R120.1, R121.1
AY_R: C9.1, R116.2, R118.1, R122.1, R123.1
BC1: U44.29 (BC1)
BDIR: U44.27 (BDIR)
D0: U44.37 (D0)
D1: U44.36 (D1)
D2: U44.35 (D2)
D3: U44.34 (D3)
D4: U44.33 (D4)
D5: U44.32 (D5)
D6: U44.31 (D6)
D7: U44.30 (D7)
GNDD: J11.2, J11.3, J12.2, R107.1, R114.1, R119.1, RV1.3, RV2.3, RV3.3, U42.4 (GND), U42.8 (GND), U44.1 (GND)
LO6: U44.24 (nA9)
LS: C9.1
unnamed: C9.1, RV1.2, RV2.2
unnamed: C9.2, RV1.1, RV2.1, U42.6 (IN2), U42.7 (IN1)
unnamed: C19.1, U42.1 (OUT1)
unnamed: C19.2, J11.1
unnamed: C20.1, U42.3 (OUT2)
unnamed: C20.2, J11.4
unnamed: J12.1, R115.1
unnamed: J12.4, R116.1
unnamed: R107.2, R120.2, U44.4 (A)
unnamed: R114.2, R121.2, R122.2, U44.3 (B)
unnamed: R117.2, R118.2, RV3.2
unnamed: R119.2, R123.2, U44.38 (C)
unnamed: U18.2 (D), U18.6 (~Q)
unnamed: U18.5 (Q), U44.22 (CLK)
VCC: J12.3, U18.1 (~R), U18.4 (~S), U42.2 (Vcc), U44.25 (A8), U44.28 (BC2), U44.40 (VCC)
bCLK: U18.3 (C)
nPOR: U44.23 (nRESET)
