ceteras/Cobra-XP/kicad/config_selection.kicad_sch

## KiCad design kicad/config_selection.kicad_sch (2024-11-02)

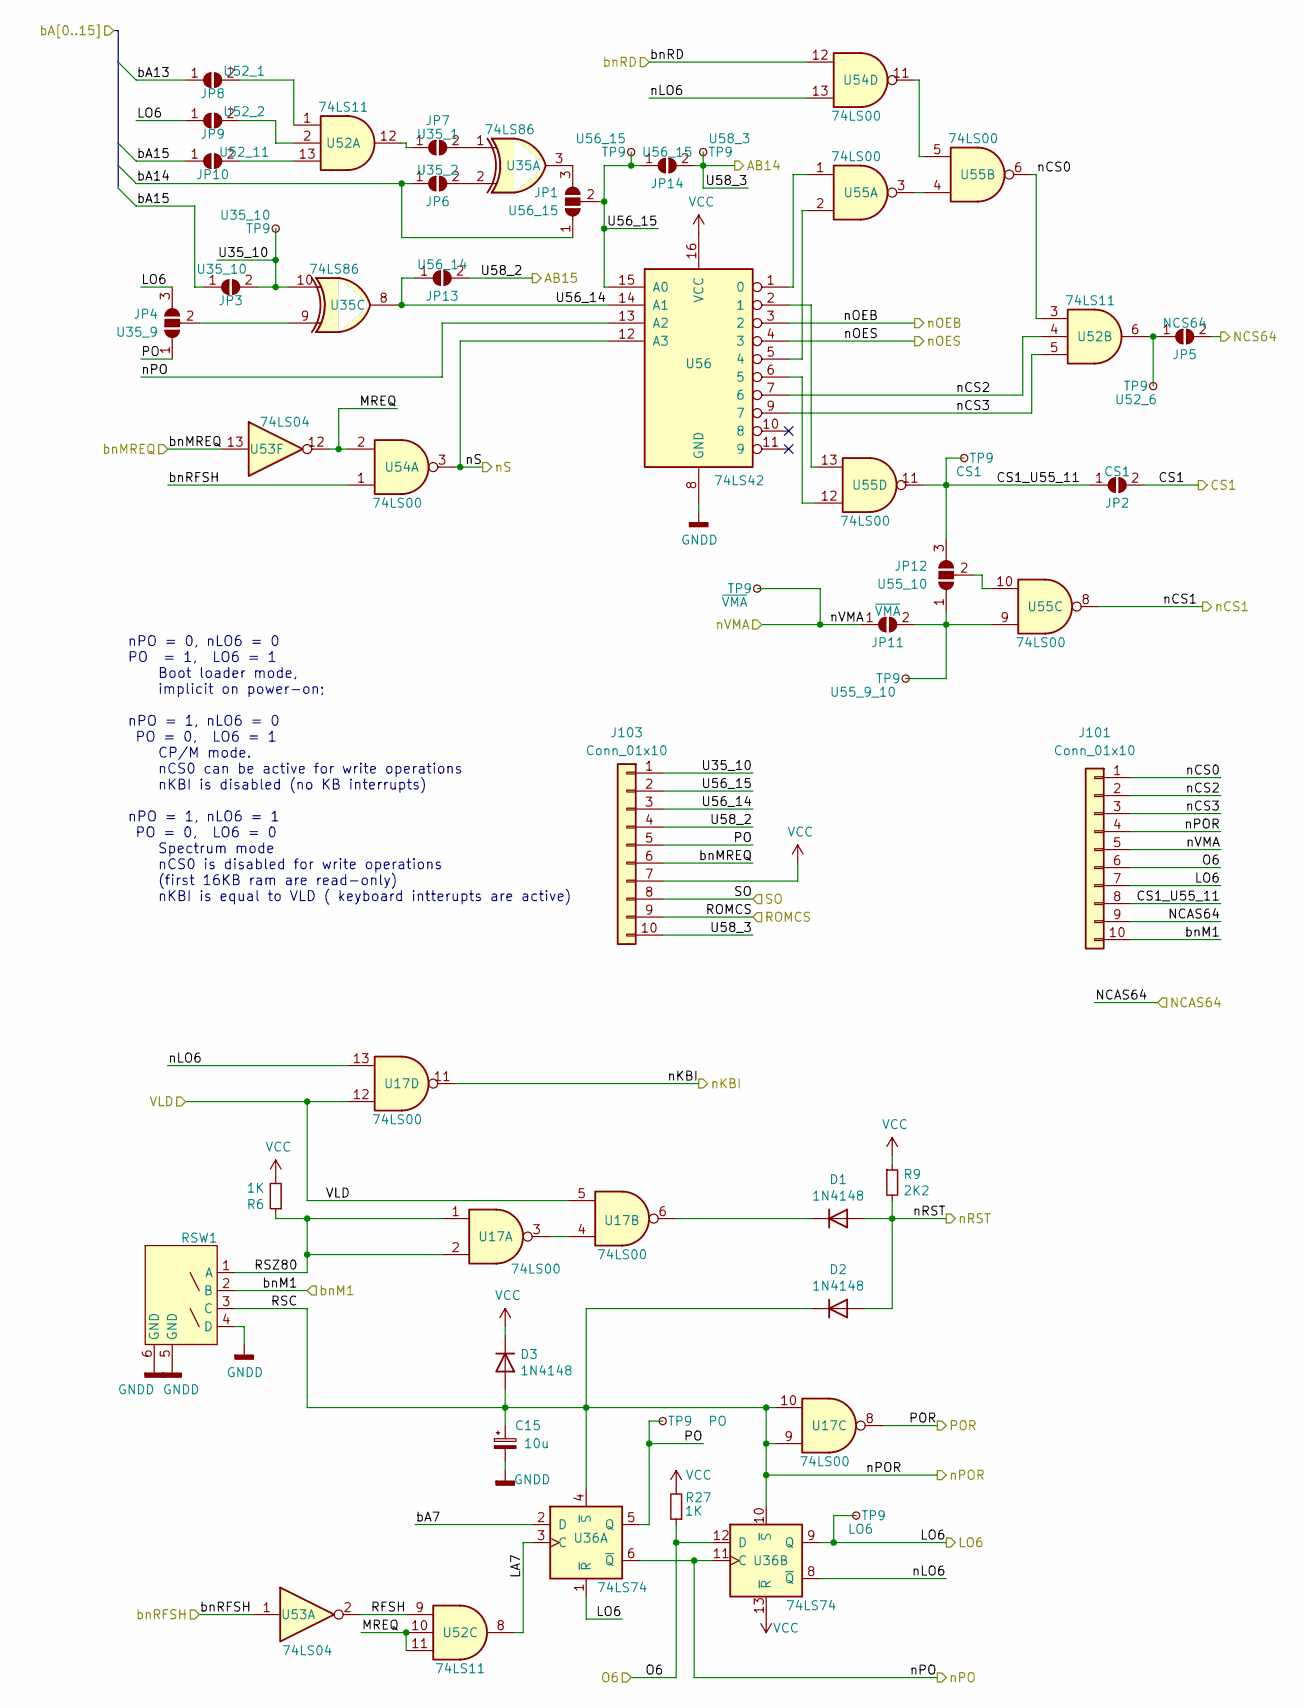
[picture p16: schematic config_selection.kicad_sch]

Parts:
C15: 10u; C_THT_508_254
D1, D2, D3: 1N4148; D_DO-35_SOD27_P7.62mm_Horizontal
J101, J103: Conn_01x10; PinHeader_1x10_P2.54mm_Vertical
JP1: U56_15; SolderJumper-3_P2.0mm_Open_TrianglePad1.0x1.5mm
JP2: CS1; SolderJumper-2_P1.3mm_Open_TrianglePad1.0x1.5mm
JP3: U35_10; SolderJumper-2_P1.3mm_Open_TrianglePad1.0x1.5mm
JP4: U35_9; SolderJumper-3_P2.0mm_Open_TrianglePad1.0x1.5mm
JP5: NCS64; SolderJumper-2_P1.3mm_Open_TrianglePad1.0x1.5mm
JP6: U35_2; SolderJumper-2_P1.3mm_Open_TrianglePad1.0x1.5mm
JP7: U35_1; SolderJumper-2_P1.3mm_Open_TrianglePad1.0x1.5mm
JP8: U52_1; SolderJumper-2_P1.3mm_Open_TrianglePad1.0x1.5mm
JP9: U52_2; SolderJumper-2_P1.3mm_Open_TrianglePad1.0x1.5mm
JP10: U52_11; SolderJumper-2_P1.3mm_Open_TrianglePad1.0x1.5mm
JP11: ~{VMA}; SolderJumper-2_P1.3mm_Open_TrianglePad1.0x1.5mm
JP12: U55_10; SolderJumper-3_P2.0mm_Open_TrianglePad1.0x1.5mm
JP13: U56_14; SolderJumper-2_P1.3mm_Open_TrianglePad1.0x1.5mm
JP14: U56_15; SolderJumper-2_P1.3mm_Open_TrianglePad1.0x1.5mm
R6, R27: 1K; R_Axial_DIN0204_L3.6mm_D1.6mm_P5.08mm_Horizontal
R9: 2K2; R_Axial_DIN0204_L3.6mm_D1.6mm_P5.08mm_Horizontal
RSW1: Reset_Switch
TP9: PO; TestPoint_Hole_D1mm_Drill0.6mm
U17, U54, U55: 74LS00; DIP-14_W7.62mm
U35: 74LS86; DIP-14_W7.62mm
U36: 74LS74; DIP-14_W7.62mm
U52: 74LS11; DIP-14_W7.62mm
U53: 74LS04; DIP-14_W7.62mm
U56: 74LS42; DIP-16_W7.62mm

Connections:
AB14: J103.10, JP14.2 (B), TP9.1
AB15: J103.4, JP13.2 (B)
CS1: JP2.2 (B)
CS1_U55_11: J101.8, JP2.1 (A), JP12.3 (B), TP9.1, U55.11
GNDD: C15.2, RSW1.4 (D), RSW1.5 (GND), RSW1.6 (GND), U56.8 (GND)
LA7: U36.3 (C), U52.8
LO6: J101.7, JP4.3 (B), JP9.1 (A), TP9.1, U36.1 (~R), U36.9 (Q)
MREQ: U52.10, U52.11, U53.12, U54.2
NCAS64: J101.9
NCS64: JP5.2 (B)
unnamed: D1.1 (K), U17.6
unnamed: JP1.3 (B), U35.3
unnamed: JP4.2 (C), U35.9
unnamed: JP5.1 (A), TP9.1, U52.6
unnamed: JP6.2 (B), U35.2
unnamed: JP7.1 (A), U52.12
unnamed: JP7.2 (B), U35.1
unnamed: JP8.2 (B), U52.1
unnamed: JP9.2 (B), U52.2
unnamed: JP10.2 (B), U52.13
unnamed: JP11.2 (B), JP12.1 (A), TP9.1, U55.9
unnamed: JP12.2 (C), U55.10
unnamed: U17.3, U17.4
unnamed: U54.11, U55.5
unnamed: U55.1, U56.1 (0)
unnamed: U55.2, U56.5 (4)
unnamed: U55.3, U55.4
unnamed: U55.12, U56.6 (5)
unnamed: U55.13, U56.2 (1)
O6: J101.6, R27.1, U36.12 (D)
PO: J103.5, JP4.1 (A), TP9.1, U36.5 (Q)
POR: U17.8
RFSH: U52.9, U53.2
ROMCS: J103.9
RSZ80: R6.1, RSW1.1 (A), U17.1, U17.2
SO: J103.8
U35_10: J103.1, JP3.2 (B), TP9.1, U35.10
U56_14: J103.3, JP13.1 (A), U35.8, U56.14 (A1)
U56_15: J103.2, JP1.2 (C), JP14.1 (A), TP9.1, U56.15 (A0)
VCC: D3.1 (K), J103.7, R6.2, R9.1, R27.2, U36.13 (~R), U56.16 (VCC)
VLD: U17.5, U17.12
bA7: U36.2 (D)
bA13: JP8.1 (A)
bA14: JP1.1 (A), JP6.1 (A)
bA15: JP3.1 (A), JP10.1 (A)
bnM1: J101.10, RSW1.2 (B)
bnMREQ: J103.6, U53.13
bnRD: U54.12
bnRFSH: U53.1, U54.1
nCS0: J101.1, U52.3, U55.6
nCS1: U55.8
nCS2: J101.2, U52.4, U56.7 (6)
nCS3: J101.3, U52.5, U56.9 (7)
nKBI: U17.11
nLO6: U17.13, U36.8 (~Q), U54.13
nOEB: U56.3 (2)
nOES: U56.4 (3)
nPO: U36.6 (~Q), U36.11 (C), U56.13 (A2)
nPOR: C15.1, D2.1 (K), D3.2 (A), J101.4, RSW1.3 (C), U17.9, U17.10, U36.4 (~S), U36.10 (~S)
nRST: D1.2 (A), D2.2 (A), R9.2
nS: U54.3, U56.12 (A3)
nVMA: J101.5, JP11.1 (A), TP9.1

Notes on the sheet:
nPO = 0, nLO6 = 0 PO = 1, LO6 = 1 Boot loader mode, implicit on power-on; nPO = 1, nLO6 = 0 PO = 0, LO6 = 1 CP/M mode. nCS0 can be active for write operations nKBI is disabled (no KB interrupts) nPO = 1, nLO6 = 1 PO = 0, LO6 = 0 Spectrum mode nCS0 is disabled for write operations (first 16KB ram ar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
