ceteras/Cobra-XP/kicad/decoupling_power.kicad_sch

## KiCad design kicad/decoupling_power.kicad_sch (2024-11-02)

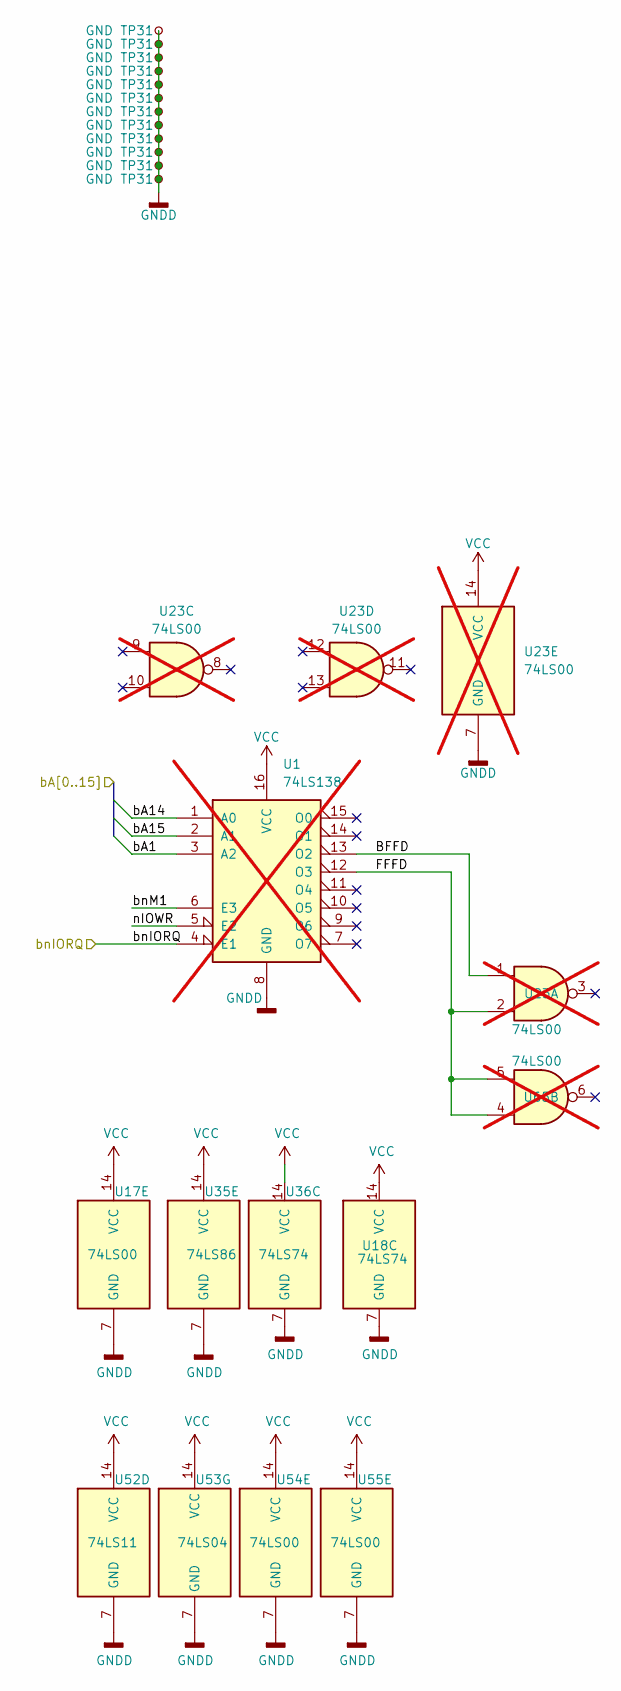
[picture p17: schematic decoupling_power.kicad_sch]

Parts:
TP31: GND; TestPoint_Loop_D1.80mm_Drill1.0mm_Beaded
U1: 74LS138; DIP-16_W7.62mm; not fitted
U17, U54, U55: 74LS00; DIP-14_W7.62mm
U18, U36: 74LS74; DIP-14_W7.62mm
U23, U65: 74LS00; DIP-14_W7.62mm; not fitted
U35: 74LS86; DIP-14_W7.62mm
U52: 74LS11; DIP-14_W7.62mm
U53: 74LS04; DIP-14_W7.62mm

Connections:
BFFD: U1.13 (O2), U23.1
FFFD: U1.12 (O3), U23.2, U65.4, U65.5
GNDD: TP31.1, U1.8 (GND), U17.7 (GND), U18.7 (GND), U23.7 (GND), U35.7 (GND), U36.7 (GND), U52.7 (GND), U53.7 (GND), U54.7 (GND), U55.7 (GND)
VCC: U1.16 (VCC), U17.14 (VCC), U18.14 (VCC), U23.14 (VCC), U35.14 (VCC), U36.14 (VCC), U52.14 (VCC), U53.14 (VCC), U54.14 (VCC), U55.14 (VCC)
bA1: U1.3 (A2)
bA14: U1.1 (A0)
bA15: U1.2 (A1)
bnIORQ: U1.4 (E1)
bnM1: U1.6 (E3)
nIOWR: U1.5 (E2)
