ceteras/Cobra-XP/(commit log)

2024-11-03 add doc folder, ro and en readme
    [Jumpers.ods, Z80_CPU.kicad_sch, video_generator.kicad_sch]
2024-11-03 new gerbers
2024-11-03 update to doc
    [Jumpers.ods]
2024-11-03 pcb update: logo
2024-11-03 aligned pin headers, qr code on the silkscreen, new image, updated readmes
2024-11-03 pcb cleanup, updated DIN connector pinout
2024-11-04 add extension template
    [template.kicad_pcb, template.kicad_sch]
2024-12-01 Update jumper docs
    [Jumpers.ods, Jumpers.xlsx]
2024-12-08 doc update
    [Jumpers.xlsx]
